andrew-pasc-27/Face_tracker_AP_Personal_Project/stl/AP_gimbal_assembly_2.stl

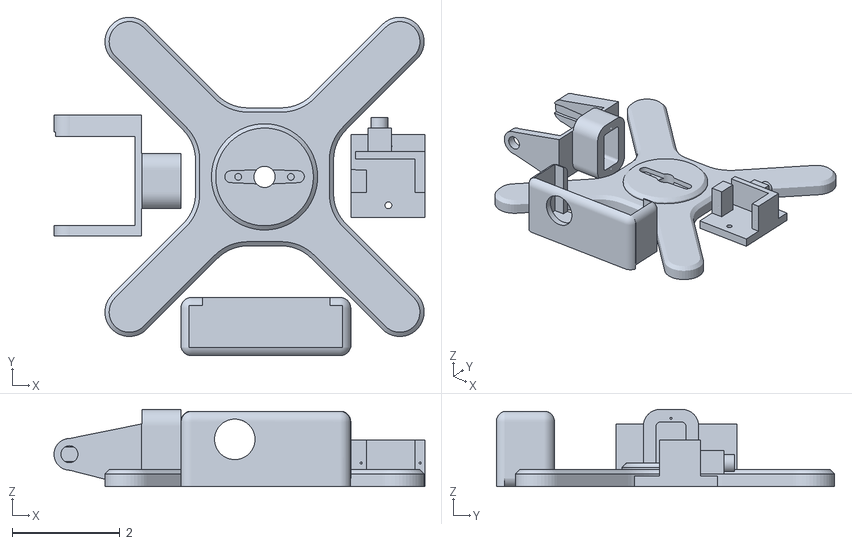
[picture p4: CAD file, 2026-10-28]
stl/AP_gimbal_assembly_2.stl
6.88 x 6.27 x 1.43
