andrew-pasc-27/Face_tracker_AP_Personal_Project/stl/ap_first_main_assembly.stl

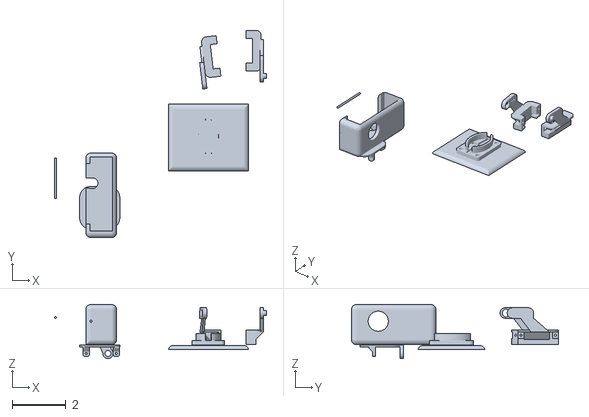
[picture p5: CAD file, 2026-10-28]
stl/ap_first_main_assembly.stl
7.89 x 7.71 x 2.01
