andrew-pasc-27/Face_tracker_AP_Personal_Project/photos+videos/wiring_diagram.png

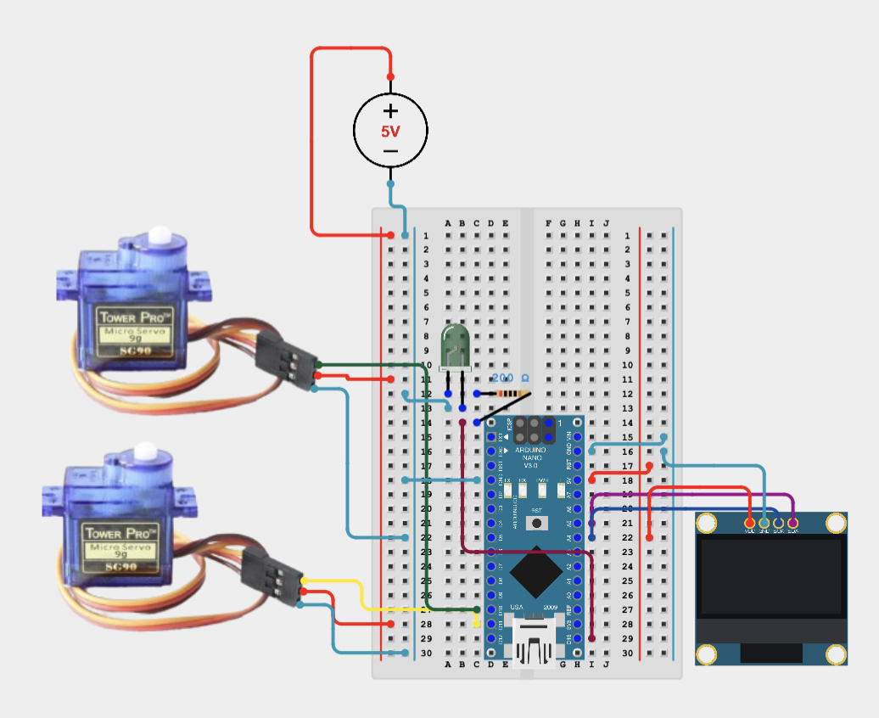
photos+videos/wiring_diagram.png
