andrew-pasc-27/Face_tracker_AP_Personal_Project/(commit log)

2026-10-19 Model data and supporting files
    [augmented_labels.csv, augmented_points.csv, combined_labeled_y_labels.csv, labels.csv, points.csv]
2026-10-19 Organize files in folders
    [augmented_labels.csv, augmented_points.csv, combined_labeled_y_labels.csv, labels.csv, points.csv]
2026-10-26 Add model with confidence
    Added new model + supporting files of model with confidence, reorganized files into "src", "dataset", and "models"
    [blank_labels.csv]
2026-10-28 Added STLs, reorganized files
    [AP_gimbal_assembly_2.stl, ap_first_main_assembly.stl]
2026-10-29 Added Comments, Updated Readme
    [test_images_data - test_labels.csv]
2026-10-30 Requirements.txt and Arduino Screen Connection
